Kronbii/star-tracker/figures/cad_contact_39deg.png

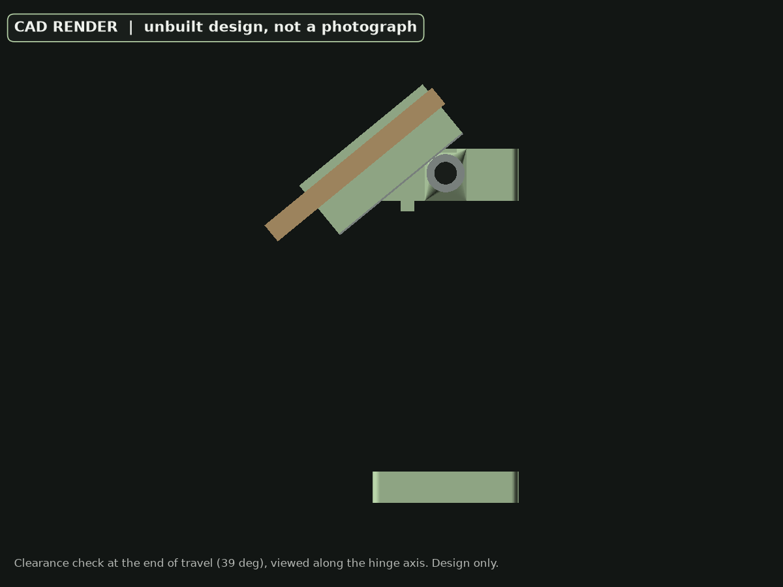
figures/cad_contact_39deg.png
