Kronbii/star-tracker/figures/cad_in_use.png

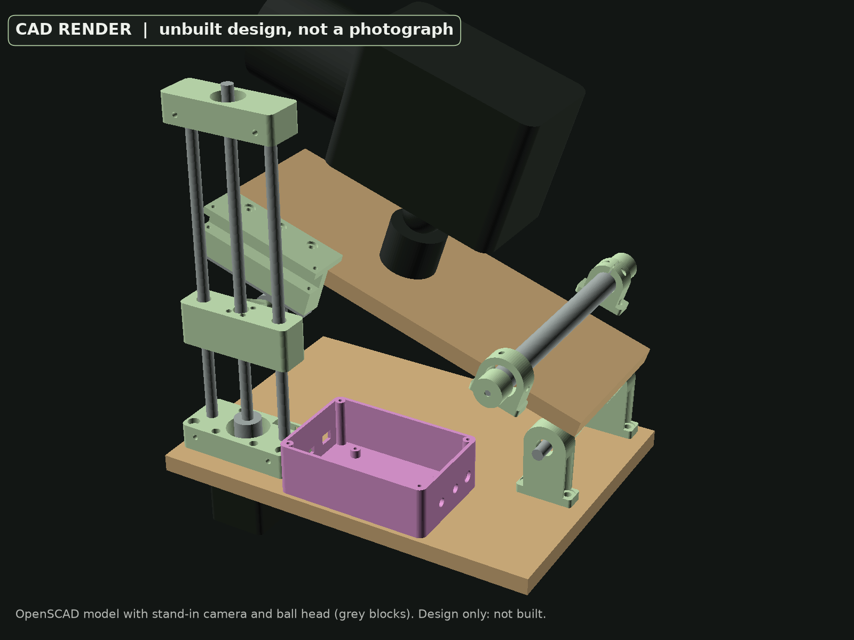
figures/cad_in_use.png
