Kronbii/star-tracker/figures/error_budget_200mm.png

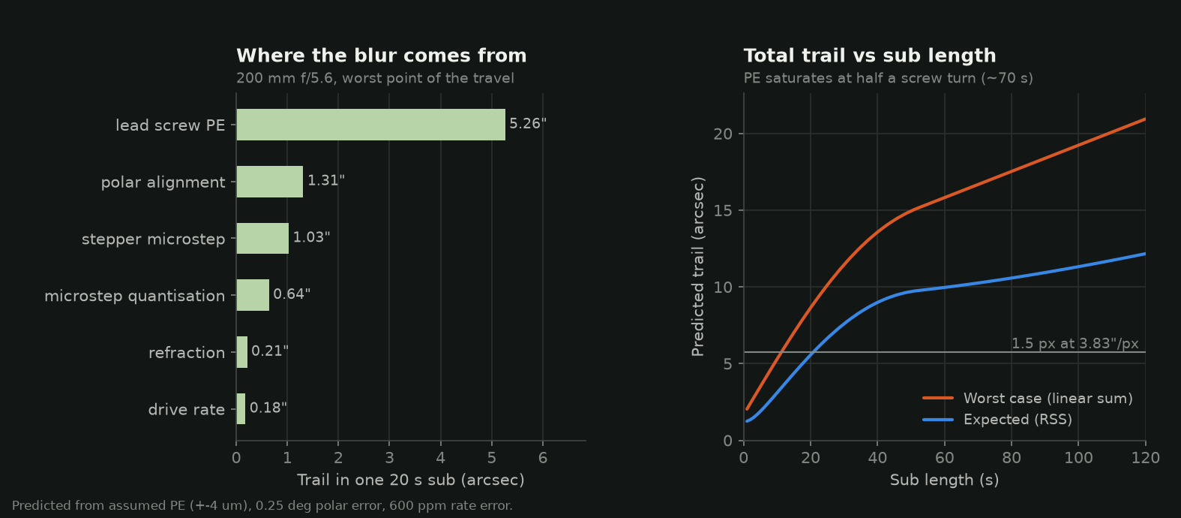
figures/error_budget_200mm.png
