Kronbii/star-tracker/figures/hero_render.png

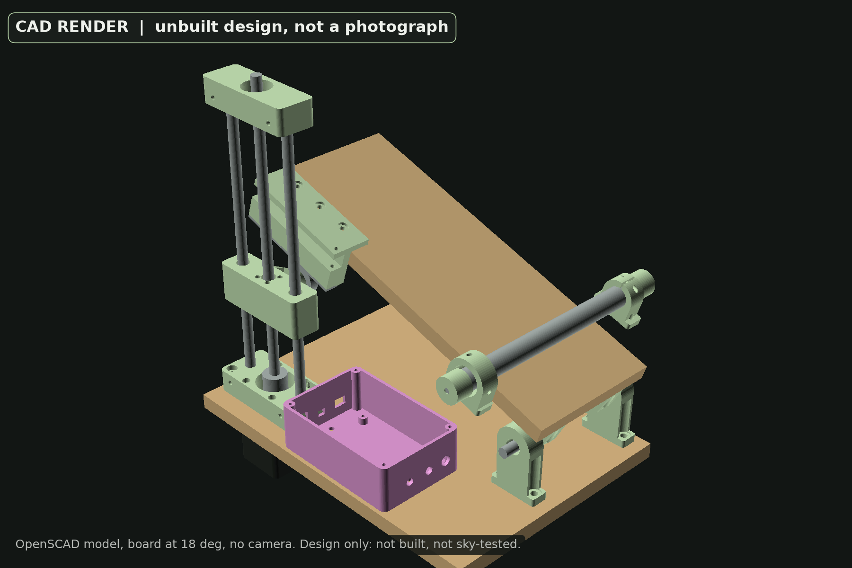
figures/hero_render.png
