Kronbii/star-tracker/figures/pa_vs_pe_sensitivity.png

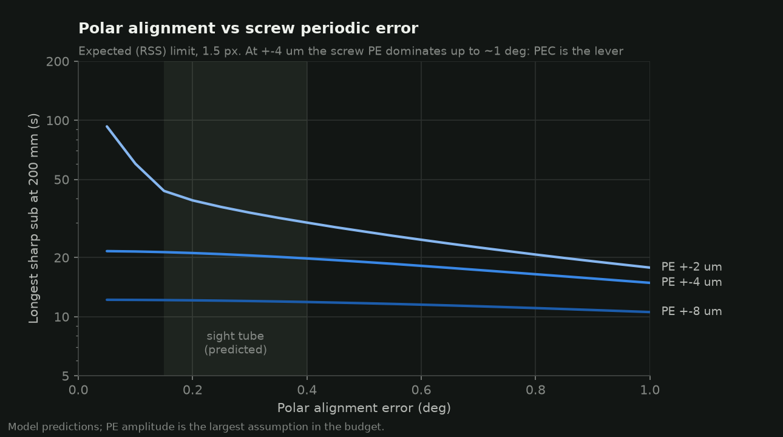
figures/pa_vs_pe_sensitivity.png
