Kronbii/star-tracker/cad/stl/electronics_lid.stl

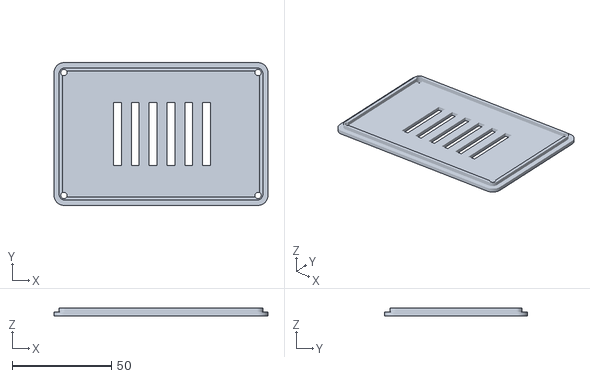
[picture p12: CAD file, 2026-10-09]
cad/stl/electronics_lid.stl
108.0 x 72.0 x 4.00
