Kronbii/star-tracker/cad/stl/sight_cradle_rear.stl

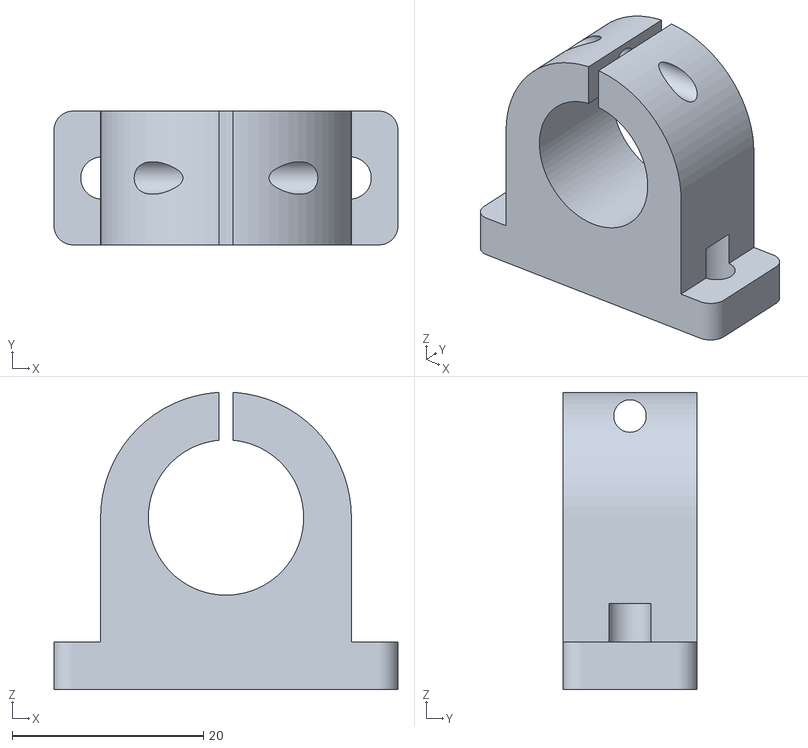
[picture p13: CAD file, 2026-10-09]
cad/stl/sight_cradle_rear.stl
36.0 x 14.0 x 31.1
