Kronbii/star-tracker/cad/stl/sight_cap_eye.stl

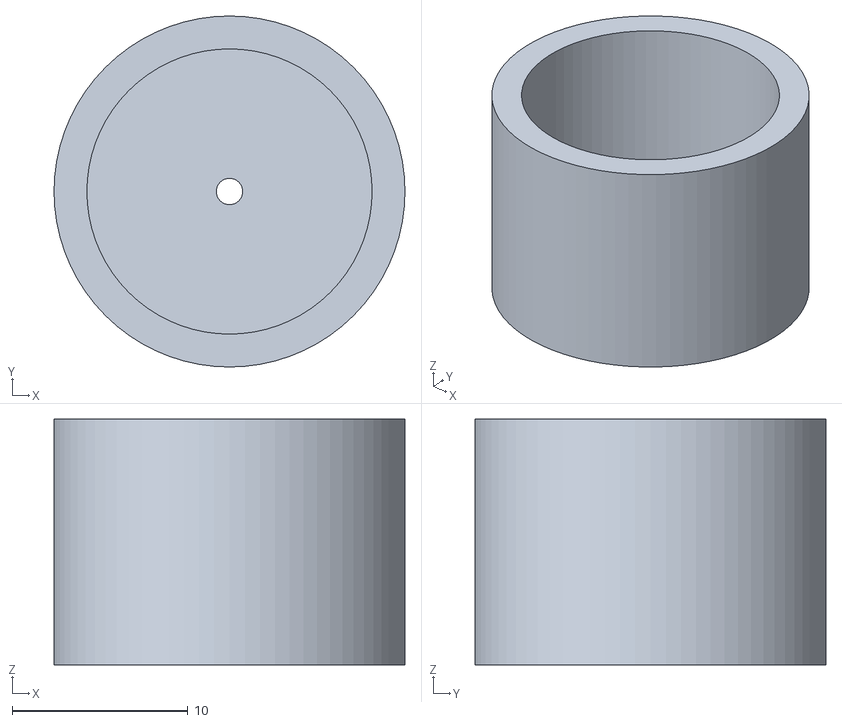
[picture p14: CAD file, 2026-10-09]
cad/stl/sight_cap_eye.stl
20.0 x 20.0 x 14.0
