Kronbii/star-tracker/cad/stl/drive_cap.stl

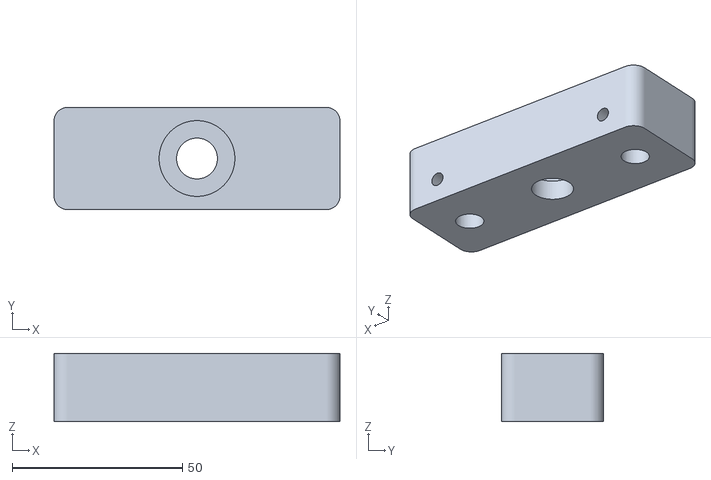
[picture p15: CAD file, 2026-10-09]
cad/stl/drive_cap.stl
84.0 x 30.0 x 20.0
