Kronbii/star-tracker/cad/stl/hinge_block.stl

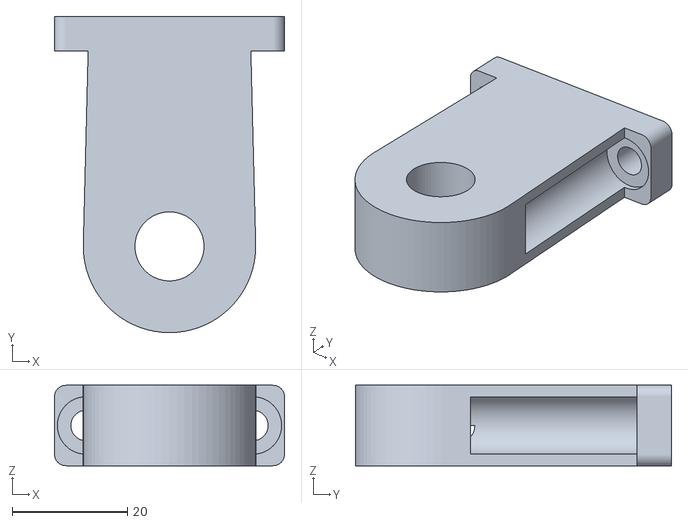
[picture p16: CAD file, 2026-10-09]
cad/stl/hinge_block.stl
40.0 x 55.0 x 14.0
