Kronbii/star-tracker/cad/stl/electronics_box.stl

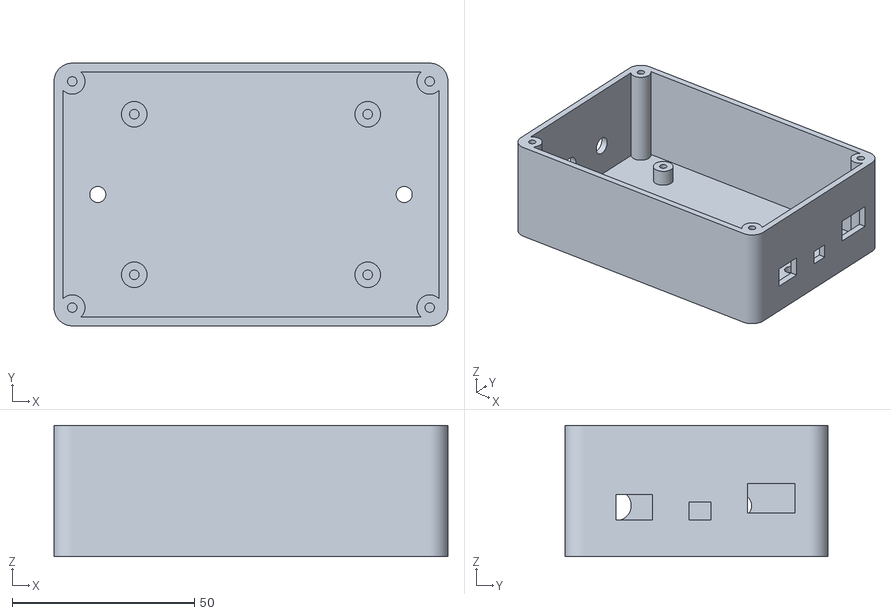
[picture p17: CAD file, 2026-10-09]
cad/stl/electronics_box.stl
108.0 x 72.0 x 36.0
