Kronbii/star-tracker/cad/stl/sight_cradle_front.stl

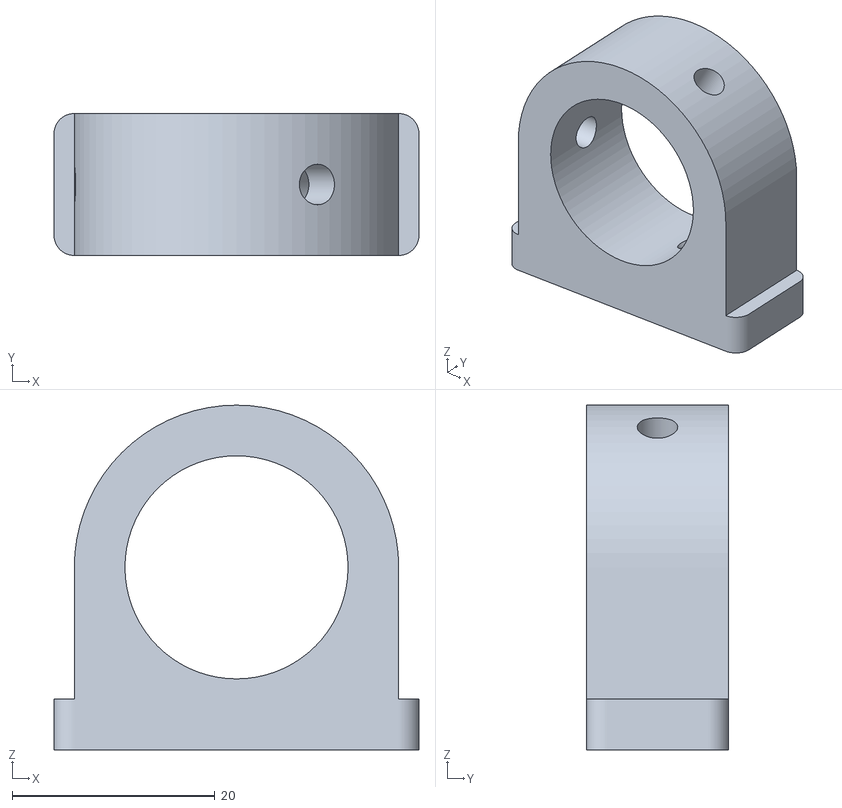
[picture p18: CAD file, 2026-10-09]
cad/stl/sight_cradle_front.stl
36.0 x 14.0 x 34.0
