Kronbii/star-tracker/cad/stl/strike_bracket.stl

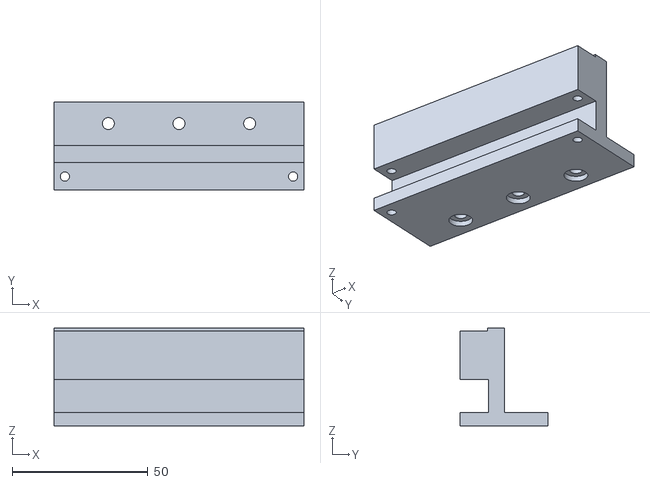
[picture p19: CAD file, 2026-10-09]
cad/stl/strike_bracket.stl
92.0 x 32.5 x 36.0
