Kronbii/star-tracker/cad/stl/drive_base.stl

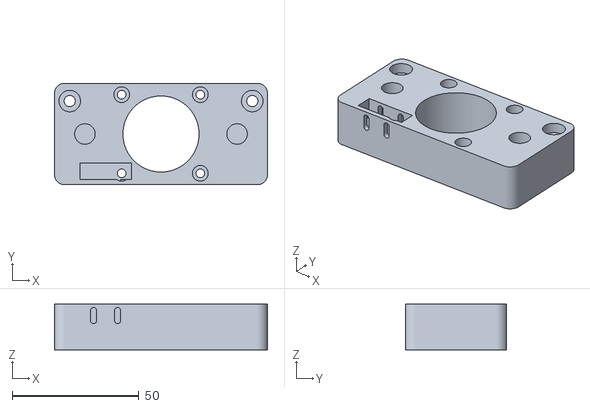
[picture p20: CAD file, 2026-10-09]
cad/stl/drive_base.stl
84.0 x 40.0 x 18.0
