Kronbii/star-tracker/cad/stl/sight_cap_reticle.stl

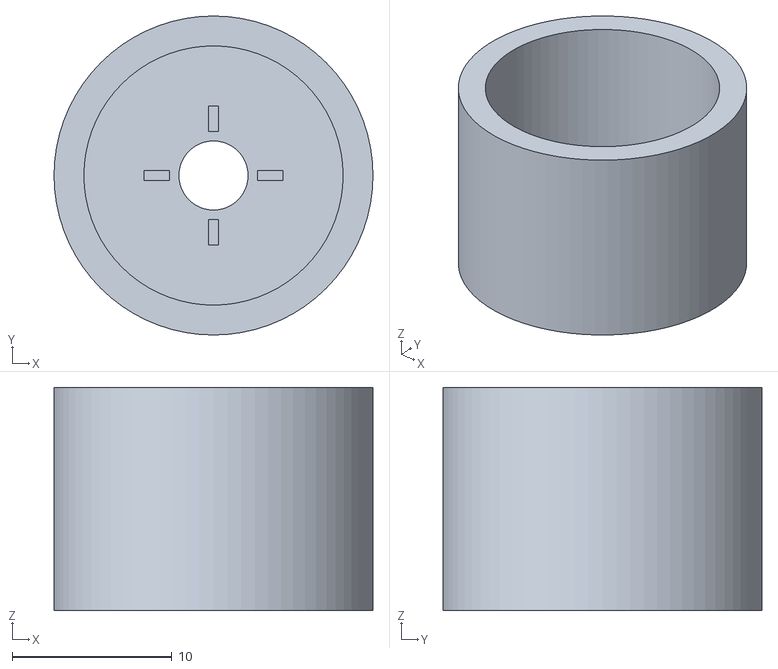
[picture p21: CAD file, 2026-10-09]
cad/stl/sight_cap_reticle.stl
20.0 x 20.0 x 14.0
