Kronbii/star-tracker/cad/stl/hinge_clamp.stl

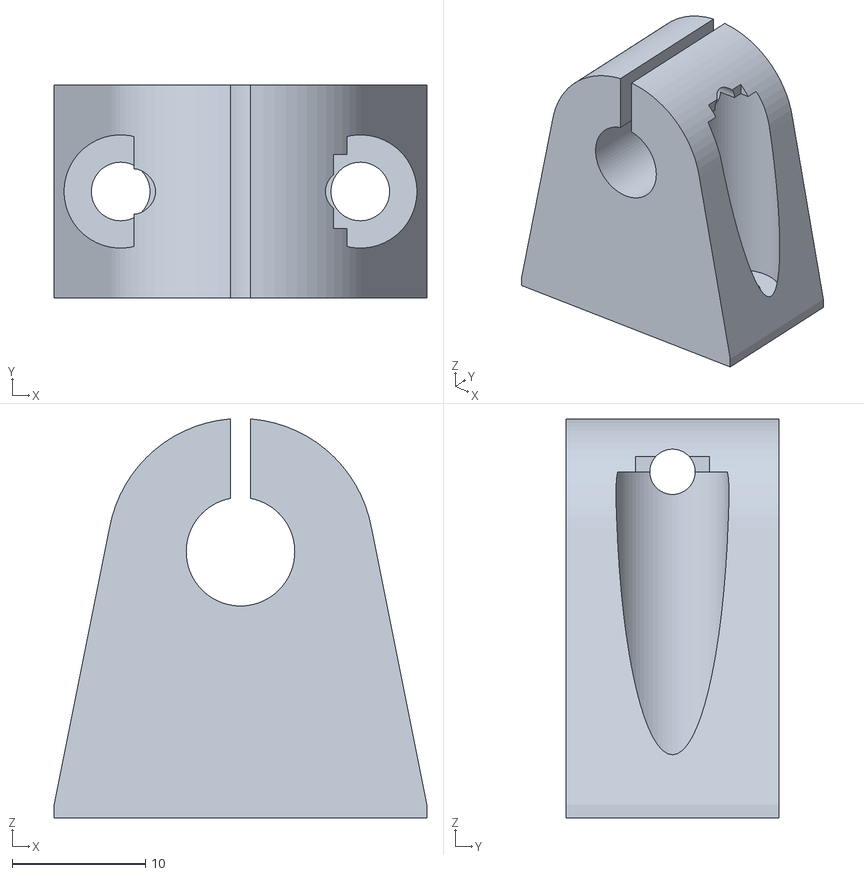
[picture p22: CAD file, 2026-10-09]
cad/stl/hinge_clamp.stl
28.0 x 16.0 x 30.0
