Kronbii/star-tracker/cad/stl/bahtinov_mask.stl

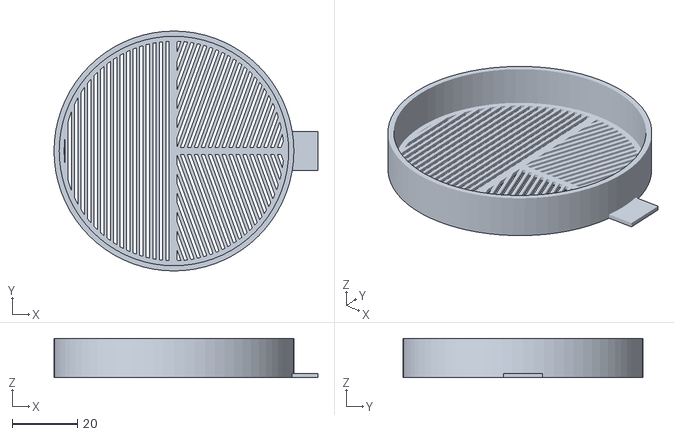
[picture p23: CAD file, 2026-10-09]
cad/stl/bahtinov_mask.stl
81.0 x 73.6 x 12.0
