Kronbii/star-tracker/cad/stl/carriage.stl

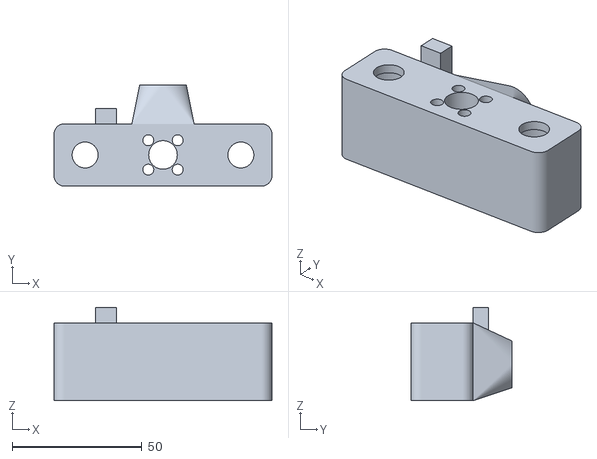
[picture p24: CAD file, 2026-10-09]
cad/stl/carriage.stl
84.0 x 39.0 x 36.0
