Kronbii/star-tracker/(commit log)

2026-10-08 Start star-tracker repository: licences and ignores
    Code is MIT; the hardware design (CAD, BOM, wiring) is CERN-OHL-P-2.0.
2026-10-08 Add hardware-independent tracker core with host unit tests
    Barn-door geometry with roller contact and closed-form inverse, position-based
    sidereal/lunar/solar tracking (no tangent error, no accumulated rounding),
    trapezoidal slews, homing state machine, pulse guiding, PEC table, step queue,
    Canon intervalometer, command parser and Polaris hour-angle aid. 53 tests run
    on the host under ASan/UBSan; track_sim exports a tracking run as CSV.
    [command.cpp, command.h, geometry.cpp, geometry.h, intervalometer.cpp, intervalometer.h, motion.cpp]
2026-10-08 Add ESP32 firmware: step ISR, web UI, serial console, NVS settings
    20 kHz integer-only timer ISR executes queued step events; a 1 kHz motion task
    feeds the home switch, intervalometer and queue under a mutex. Wi-Fi AP with a
    red night-mode web UI (tracking, homing, jog, BULB sequences, Polaris clock),
    serial console with the same commands, BOOT-button track/home, dim LED.
    Compiles with arduino-cli for esp32:esp32:esp32 (core 3.3.11) with no warnings.
2026-10-09 Add Python modelling tools: error budget, exposure and M42 planner
    startracker package: barn-door geometry mirror (cross-checked against the C++
    core's track_sim output), tracking-error model (exact polar-misalignment
    rotation, screw/microstep PE, rate-error budget, refraction) giving the
    longest sharp sub per lens, NPF/500/300 comparison and sky-limited sub
    planning for Canon APS-C, skyfield+DE421 planner for M42 from Beirut with a
    validated low-precision fallback, session-plan generator, autoguiding
    prototype on synthetic frames, PEC table fitting, CLI. 46 pytest tests; ruff
    clean.
2026-10-09 Add parametric OpenSCAD model, printable STLs and drill templates
    Tangent-arm barn door: 608-bearing hinge, printer-style Z tower (NEMA17,
    Tr8x2 screw, 2x 8 mm rods, LM8UU carriage with floating nut) pushing a 608
    roller against a steel strip whose face lies in the plane of the hinge axis
    (c = 11 mm). Sight tube with a Polaris-offset reticle cap and collimation
    screws, electronics box, Bahtinov mask. All parts fit a 180 mm bed;
    build.sh exports binary STLs in print orientation, 1:1 SVG drill templates
    and renders (OpenSCAD 2026.10 nightly, Manifold backend).
    [bahtinov_mask.stl, carriage.stl, drive_base.stl, drive_cap.stl, electronics_box.stl, electronics_lid.stl, hinge_block.stl, hinge_clamp.stl]
2026-10-09 Add generated figures and the first-session plan
    Figures from code (startracker figures, cad/build.sh): predicted exposure vs
    focal length, error budget at 200 mm, tangent correction from the C++ core,
    PA vs PE sensitivity, M42 season and first night from Beirut, autoguiding
    simulation, CAD renders. docs/session-plan.md from startracker plan.
    [track_sim.csv]
2026-10-10 Add BOM with estimated prices, wiring guide and repo consistency tests
    hardware/bom.csv lists part numbers and rough USD estimates (~140 USD
    excluding tripod and camera). hardware/wiring.md documents the ESP32 /
    TMC2209 / home switch / PC817 optocoupler wiring to the Canon E3 2.5 mm
    remote port. New tests check the BOM arithmetic, that every CAD part has an
    STL, and that firmware, Python and CAD geometry defaults agree.
    [bom.csv]
2026-10-10 Label every CAD render as a render of an unbuilt design
    finish_renders.py burns a 'CAD RENDER | unbuilt design, not a photograph'
    badge and a one-line caption into each OpenSCAD render so none can be taken
    for a photo of a prototype; the contact check is re-framed.
2026-10-10 Add README report, build and first-night guides, portfolio entry, CI
    README reads as a short engineering report: why track, design choice, the
    barn-door maths and microstep scheduling, firmware architecture, error budget,
    predicted performance (labelled as predicted), M42 season from Beirut,
    verification, limitations, next steps, licences. docs/ adds the build guide
    (Bambu print settings, assembly, calibration, bench tests), the first-night
    guide, the autoguiding design and docs/portfolio.md. GitHub Actions runs ruff
    + pytest, the host C++ tests and a track_sim check, an arduino-cli ESP32 build
    with a cached core, and an OpenSCAD export.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
2026-10-10 Pin the ESP32 core by install command instead of a sketch profile
    arduino-cli 1.3 could not resolve the ESP32 index's tools in profile mode, so
    sketch.yaml keeps only default_fqbn and documents the tested core (3.3.11),
    which the build guide and CI install explicitly.
